Yuto2511/RoboTrace_kicad_2023/production/RoboTrace_2023_main/MainBoard.png

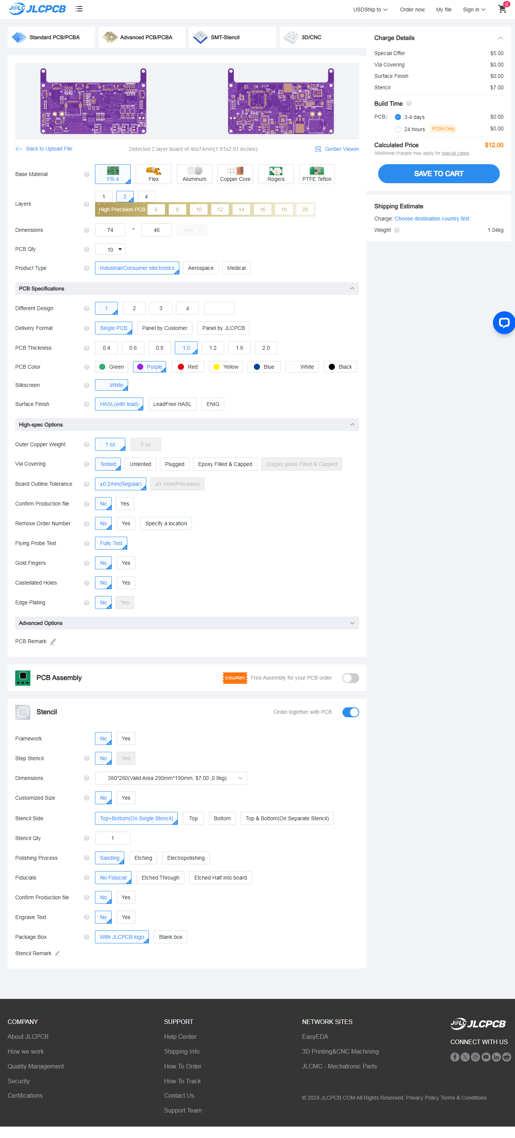
production/RoboTrace_2023_main/MainBoard.png
