Yuto2511/RoboTrace_kicad_2023/production/RoboTrace_2023_sensor/SensorsBoard.png

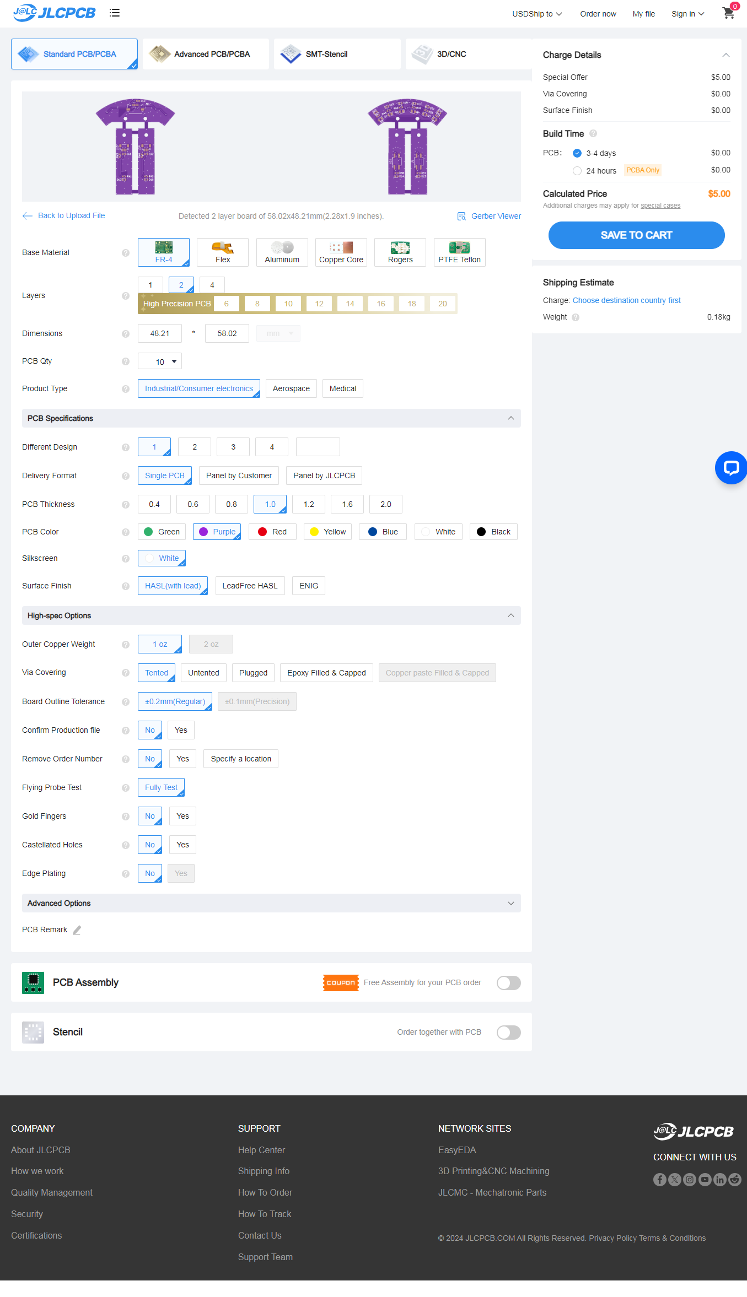
production/RoboTrace_2023_sensor/SensorsBoard.png
