Yuto2511/RoboTrace_kicad_2023/DXF/main.dxf

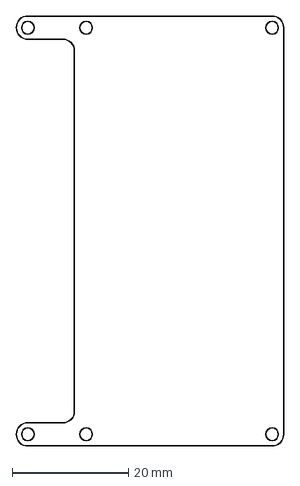
[picture p3: CAD file, 2024-01-15]
DXF/main.dxf
46.0 x 74.0 mm
