Yuto2511/RoboTrace_kicad_2023/DXF/side_sens.dxf

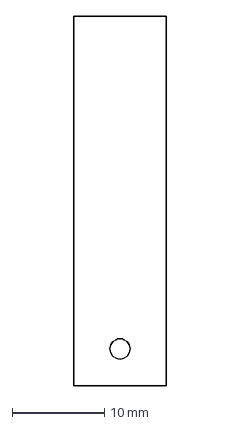
[picture p4: CAD file, 2024-01-15]
DXF/side_sens.dxf
10.0 x 40.0 mm
