Yuto2511/RoboTrace_kicad_2023/DXF/line_sens.dxf

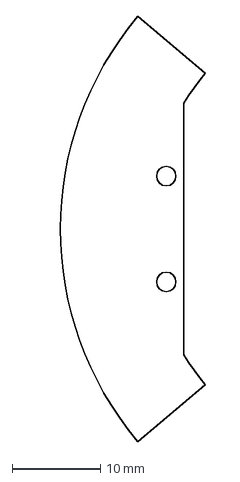
[picture p5: CAD file, 2024-01-15]
DXF/line_sens.dxf
19.4 x 48.2 mm
