Yuto2511/RoboTrace_kicad_2023/RoboTrace_2023_v2.kicad_pcb

## KiCad design RoboTrace_2023_v2.kicad_pcb (2024-01-17)

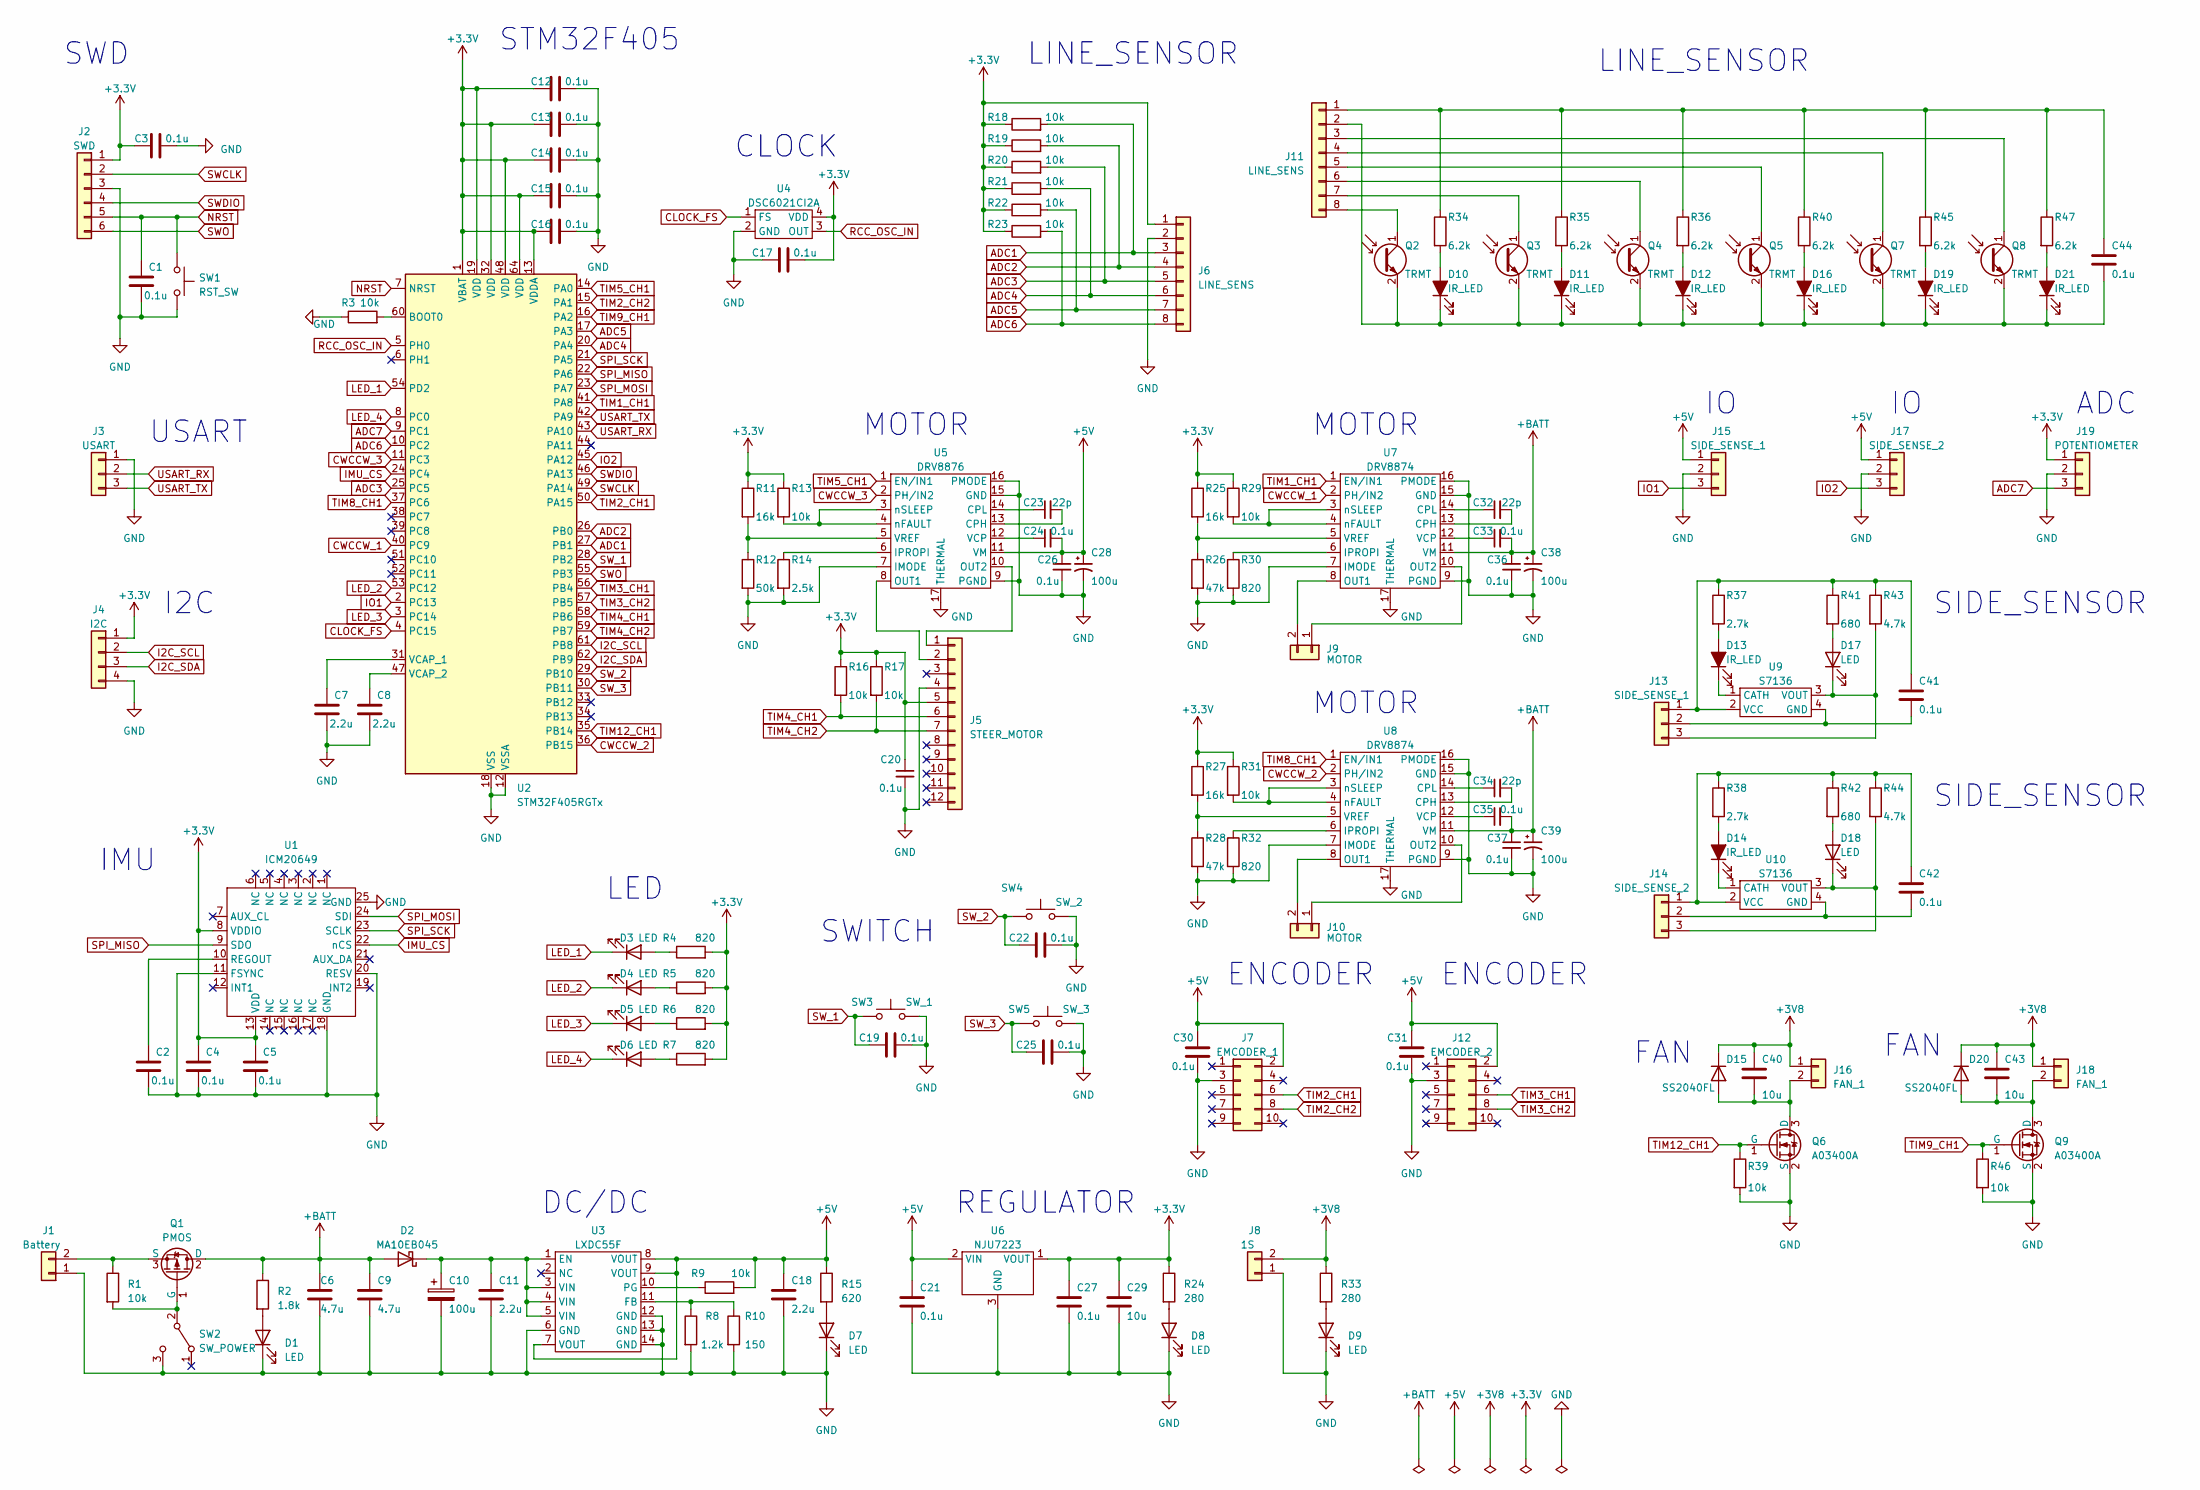
[picture p6: schematic RoboTrace_2023_v2.kicad_sch]

Parts:
C1, C2, C3, C4, C5, C12, C13, C14, C15, C16, C17, C19, C20, C21, C22, C24, C25, C26, C27, C30, C31, C33, C35, C36, C37, C41, C42, C44: 0.1u; C_0603_1608Metric
C6, C9: 4.7u; C_1206_3216Metric
C7, C8, C11, C18: 2.2u; C_0603_1608Metric
C10, C28, C38, C39: 100u; CP_EIA-7343-15_Kemet-W
C23, C32, C34: 22p; C_0603_1608Metric
C29, C40, C43: 10u; C_0805_2012Metric
D1, D3, D4, D5, D6, D7, D8, D9, D17, D18: LED; LED_0603_1608Metric
D2: MA10EB045; SO-221BC
D10, D11, D12, D13, D14, D16, D19, D21: IR_LED; LED_0603_1608Metric
D15, D20: SS2040FL; D_SOD-123F
J1: Battery; AMASS_XT30PW-M_1x02_P2.50mm_Horizontal
J2: SWD; JST_SH_BM06B-SRSS-TB_1x06-1MP_P1.00mm_Vertical
J3: USART; JST_SH_BM03B-SRSS-TB_1x03-1MP_P1.00mm_Vertical
J4: I2C; JST_SH_BM04B-SRSS-TB_1x04-1MP_P1.00mm_Vertical
J5: STEER_MOTOR; Molex_200528-0120_1x12-0.5MP_P0.50mm_Horizontal
J6, J11: LINE_SENS; Molex_200528-0080_1x08-0.5MP_P0.50mm_Horizontal
J7: EMCODER_1; PinHeader_2x05_P1.27mm_Vertical
J8: 1S; IL-G_2PIN
J9, J10: MOTOR; JST_PH_B2B-PH-K_1x02_P2.00mm_Vertical
J12: EMCODER_2; PinHeader_2x05_P1.27mm_Vertical
J13, J15: SIDE_SENSE_1; JST_SH_BM03B-SRSS-TB_1x03-1MP_P1.00mm_Vertical
J14, J17: SIDE_SENSE_2; JST_SH_BM03B-SRSS-TB_1x03-1MP_P1.00mm_Vertical
J16, J18: FAN_1; JST_PH_B2B-PH-K_1x02_P2.00mm_Vertical
J19: POTENTIOMETER; JST_SH_BM03B-SRSS-TB_1x03-1MP_P1.00mm_Vertical
Q1: PMOS; TO-252-3_TabPin2
Q2, Q3, Q4, Q5, Q7, Q8: TRMT; LED_0805_2012Metric
Q6, Q9: A03400A; SOT-23
R1, R3, R9, R13, R16, R17, R18, R19, R20, R21, R22, R23, R29, R31, R39, R46: 10k; R_0603_1608Metric
R2: 1.8k; R_0603_1608Metric
R4, R5, R6, R7, R30, R32: 820; R_0603_1608Metric
R8: 1.2k; R_0603_1608Metric
R10: 150; R_0603_1608Metric
R11, R25, R27: 16k; R_0603_1608Metric
R12: 50k; R_0603_1608Metric
R14: 2.5k; R_0603_1608Metric
R15: 620; R_0603_1608Metric
R24, R33: 280; R_0603_1608Metric
R26, R28: 47k; R_0603_1608Metric
R34, R35, R36, R40, R45, R47: 6.2k; R_0603_1608Metric
R37, R38: 2.7k; R_0603_1608Metric
R41, R42: 680; R_0603_1608Metric
R43, R44: 4.7k; R_0603_1608Metric
SW1: RST_SW; SW_SPST_B3U-1000P
SW2: SW_POWER; SSAJ12
SW3: SW_1; SW_SPST_B3U-1000P
SW4: SW_2; SW_SPST_B3U-1000P
SW5: SW_3; SW_SPST_B3U-1000P
U1: ICM20649; QFN-24-1EP_3x3mm_P0.4mm_EP1.75x1.6mm_ThermalVias
U2: STM32F405RGTx; LQFP-64_10x10mm_P0.5mm
U3: LXDC55F; LXDC55FAAA203
U4: DSC6021CI2A
U5: DRV8876; HTSSOP-16-1EP_4.4x5mm_P0.65mm_EP3.4x5mm_Mask2.46x2.31mm_The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
U6: NJU7223; TO-252-2
U7, U8: DRV8874; HTSSOP-16-1EP_4.4x5mm_P0.65mm_EP3.4x5mm_Mask2.46x2.31mm_The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
U9, U10: S7136

Connections:
+3.3V: C3.1, C4.1, C5.1, C12.1, C13.1, C14.1, C15.1, C16.1, C17.2, C20.1, C27.1, C29.1, J2.1, J4.1, J5.5, J6.1, J19.1, R4.2, R5.2, R6.2, R7.2, R11.1, R13.1, R16.1, R17.1, R18.1, R19.1, R20.1, R21.1, R22.1, R23.1, R24.1, R25.1, R27.1, R29.1, R31.1, U1.8 (VDDIO), U1.13 (VDD), U2.1 (VBAT), U2.13 (VDDA), U2.19 (VDD), U2.32 (VDD), U2.48 (VDD), U2.64 (VDD), U4.4 (VDD), U6.1 (VOUT)
+3V8: C40.1, C43.1, D15.1 (K), D20.1 (K), J8.2, J16.1, J18.1, R33.1
+5V: C18.1, C21.1, C24.2, C26.1, C28.1, C30.1, C31.1, J7.2, J12.2, J15.1, J17.1, R9.2, R15.1, U3.7 (VOUT), U3.8 (VOUT), U3.9 (VOUT), U5.11 (VM), U6.2 (VIN)
+BATT: C6.1, C9.1, C33.2, C35.2, C36.1, C37.1, C38.1, C39.1, D2.2 (A), Q1.2 (D), R2.1, U7.11 (VM), U8.11 (VM)
ADC1: J6.3, R18.2, U2.27 (PB1)
ADC2: J6.4, R19.2, U2.26 (PB0)
ADC3: J6.5, R20.2, U2.25 (PC5)
ADC4: J6.6, R21.2, U2.20 (PA4)
ADC5: J6.7, R22.2, U2.17 (PA3)
ADC6: J6.8, R23.2, U2.10 (PC2)
ADC7: J19.3, U2.9 (PC1)
CLOCK_FS: U2.4 (PC15), U4.1 (FS)
CWCCW_1: U2.40 (PC9), U7.2 (PH/IN2)
CWCCW_2: U2.36 (PB15), U8.2 (PH/IN2)
CWCCW_3: U2.11 (PC3), U5.2 (PH/IN2)
GND: C1.2, C2.2, C3.2, C4.2, C5.2, C6.2, C7.2, C8.2, C9.2, C10.2, C11.2, C12.2, C13.2, C14.2, C15.2, C16.2, C17.1, C18.2, C19.2, C20.2, C21.2, C22.2, C25.2, C26.2, C27.2, C28.2, C29.2, C30.2, C31.2, C36.2, C37.2, C38.2, C39.2, D1.1 (K), D7.1 (K), D8.1 (K), D9.1 (K), J1.1, J2.3, J3.1, J4.4, J5.4, J6.2, J7.3, J8.1, J12.3, J15.2, J17.2, J19.2, Q6.2 (S), Q9.2 (S), R3.1, R8.2, R10.2, R12.2, R14.2, R26.2, R28.2, R30.2, R32.2, R39.2, R46.2, SW1.2, SW2.3 (C), SW3.2, SW4.2, SW5.2, U1.11 (FSYNC), U1.18 (GND), U1.20 (RESV), U1.25 (GND), U2.12 (VSSA), U2.18 (VSS), U2.63 (VSS), U3.6 (GND), U3.12 (GND), U3.13 (GND), U3.14 (GND), U4.2 (GND), U5.7 (IMODE), U5.9 (PGND), U5.15 (GND), U5.16 (PMODE), U5.17 (THERMAL), U6.3 (GND), U7.7 (IMODE), U7.9 (PGND), U7.15 (GND), U7.16 (PMODE), U7.17 (THERMAL), U8.7 (IMODE), U8.9 (PGND), U8.15 (GND), U8.16 (PMODE), U8.17 (THERMAL)
I2C_SCL: J4.2, U2.61 (PB8)
I2C_SDA: J4.3, U2.62 (PB9)
IMU_CS: U1.22 (nCS), U2.24 (PC4)
IO1: J15.3, U2.2 (PC13)
IO2: J17.3, U2.45 (PA12)
LED_1: D3.1 (K), U2.54 (PD2)
LED_2: D4.1 (K), U2.53 (PC12)
LED_3: D5.1 (K), U2.3 (PC14)
LED_4: D6.1 (K), U2.8 (PC0)
NRST: C1.1, J2.5, SW1.1, U2.7 (NRST)
unnamed: D1.2 (A), R2.2
unnamed: C10.1, C11.1, D2.1 (K), U3.1 (EN), U3.3 (VIN), U3.4 (VIN), U3.5 (VIN)
unnamed: D3.2 (A), R4.1
unnamed: D4.2 (A), R5.1
unnamed: D5.2 (A), R6.1
unnamed: D6.2 (A), R7.1
unnamed: D7.2 (A), R15.2
unnamed: D8.2 (A), R24.2
unnamed: D9.2 (A), R33.2
unnamed: D10.2 (A), R34.2
unnamed: C44.2, D10.1 (K), D11.1 (K), D12.1 (K), D16.1 (K), D19.1 (K), D21.1 (K), J11.2, Q2.2 (E), Q3.2 (E), Q4.2 (E), Q5.2 (E), Q7.2 (E), Q8.2 (E)
unnamed: D11.2 (A), R35.2
unnamed: D12.2 (A), R36.2
unnamed: D13.2 (A), R37.2
unnamed: D13.1 (K), U9.1 (CATH)
unnamed: D14.2 (A), R38.2
unnamed: D14.1 (K), U10.1 (CATH)
unnamed: C40.2, D15.2 (A), J16.2, Q6.3 (D)
unnamed: D16.2 (A), R40.2
unnamed: D17.2 (A), R41.2
unnamed: D17.1 (K), J13.3, R43.2, U9.3 (VOUT)
unnamed: D18.2 (A), R42.2
unnamed: D18.1 (K), J14.3, R44.2, U10.3 (VOUT)
unnamed: D19.2 (A), R45.2
unnamed: C43.2, D20.2 (A), J18.2, Q9.3 (D)
unnamed: D21.2 (A), R47.2
unnamed: J1.2, Q1.3 (S), R1.1
unnamed: J5.1, U5.10 (OUT2)
unnamed: J5.2, U5.8 (OUT1)
unnamed: J9.1, U7.10 (OUT2)
unnamed: J9.2, U7.8 (OUT1)
unnamed: J10.1, U8.10 (OUT2)
unnamed: J10.2, U8.8 (OUT1)
unnamed: C44.1, J11.1, R34.1, R35.1, R36.1, R40.1, R45.1, R47.1
unnamed: J11.3, Q8.1 (C)
unnamed: J11.4, Q7.1 (C)
unnamed: J11.5, Q5.1 (C)
unnamed: J11.6, Q4.1 (C)
unnamed: J11.7, Q3.1 (C)
unnamed: J11.8, Q2.1 (C)
unnamed: C41.1, J13.1, R37.1, R41.1, R43.1, U9.2 (VCC)
unnamed: C41.2, J13.2, U9.4 (GND)
unnamed: C42.1, J14.1, R38.1, R42.1, R44.1, U10.2 (VCC)
unnamed: C42.2, J14.2, U10.4 (GND)
unnamed: Q1.1 (G), R1.2, SW2.2 (B)
unnamed: C2.1, U1.10 (REGOUT)
unnamed: R3.2, U2.60 (BOOT0)
unnamed: C7.1, U2.31 (VCAP_1)
unnamed: C8.1, U2.47 (VCAP_2)
unnamed: R8.1, R10.1, U3.11 (FB)
unnamed: R9.1, U3.10 (PG)
unnamed: C23.2, U5.13 (CPH)
unnamed: C23.1, U5.14 (CPL)
unnamed: R14.1, U5.6 (IPROPI)
unnamed: C24.1, U5.12 (VCP)
unnamed: R11.2, R12.1, U5.5 (VREF)
unnamed: R13.2, U5.3 (nSLEEP), U5.4 (nFAULT)
unnamed: C32.2, U7.13 (CPH)
unnamed: C32.1, U7.14 (CPL)
unnamed: R30.1, U7.6 (IPROPI)
unnamed: C33.1, U7.12 (VCP)
unnamed: R25.2, R26.1, U7.5 (VREF)
unnamed: R29.2, U7.3 (nSLEEP), U7.4 (nFAULT)
unnamed: C34.2, U8.13 (CPH)
unnamed: C34.1, U8.14 (CPL)
unnamed: R32.1, U8.6 (IPROPI)
unnamed: C35.1, U8.12 (VCP)
unnamed: R27.2, R28.1, U8.5 (VREF)
unnamed: R31.2, U8.3 (nSLEEP), U8.4 (nFAULT)
RCC_OSC_IN: U2.5 (PH0), U4.3 (OUT)
SPI_MISO: U1.9 (SDO), U2.22 (PA6)
SPI_MOSI: U1.24 (SDI), U2.23 (PA7)
SPI_SCK: U1.23 (SCLK), U2.21 (PA5)
SWCLK: J2.2, U2.49 (PA14)
SWDIO: J2.4, U2.46 (PA13)
SWO: J2.6, U2.55 (PB3)
SW_1: C19.1, SW3.1, U2.28 (PB2)
SW_2: C22.1, SW4.1, U2.29 (PB10)
SW_3: C25.1, SW5.1, U2.30 (PB11)
TIM1_CH1: U2.41 (PA8), U7.1 (EN/IN1)
TIM2_CH1: J7.6, U2.50 (PA15)
TIM2_CH2: J7.8, U2.15 (PA1)
TIM3_CH1: J12.6, U2.56 (PB4)
TIM3_CH2: J12.8, U2.57 (PB5)
TIM4_CH1: J5.6, R16.2, U2.58 (PB6)
TIM4_CH2: J5.7, R17.2, U2.59 (PB7)
TIM5_CH1: U2.14 (PA0), U5.1 (EN/IN1)
TIM8_CH1: U2.37 (PC6), U8.1 (EN/IN1)
TIM9_CH1: Q9.1 (G), R46.1, U2.16 (PA2)
TIM12_CH1: Q6.1 (G), R39.1, U2.35 (PB14)
USART_RX: J3.2, U2.43 (PA10)
USART_TX: J3.3, U2.42 (PA9)

Notes on the sheet:
MOTOR
ENCODER
CLOCK
SWITCH
SIDE_SENSOR
REGULATOR
SWD
FAN
DC/DC
STM32F405
LINE_SENSOR
LED
ADC
USART
I2C
IMU

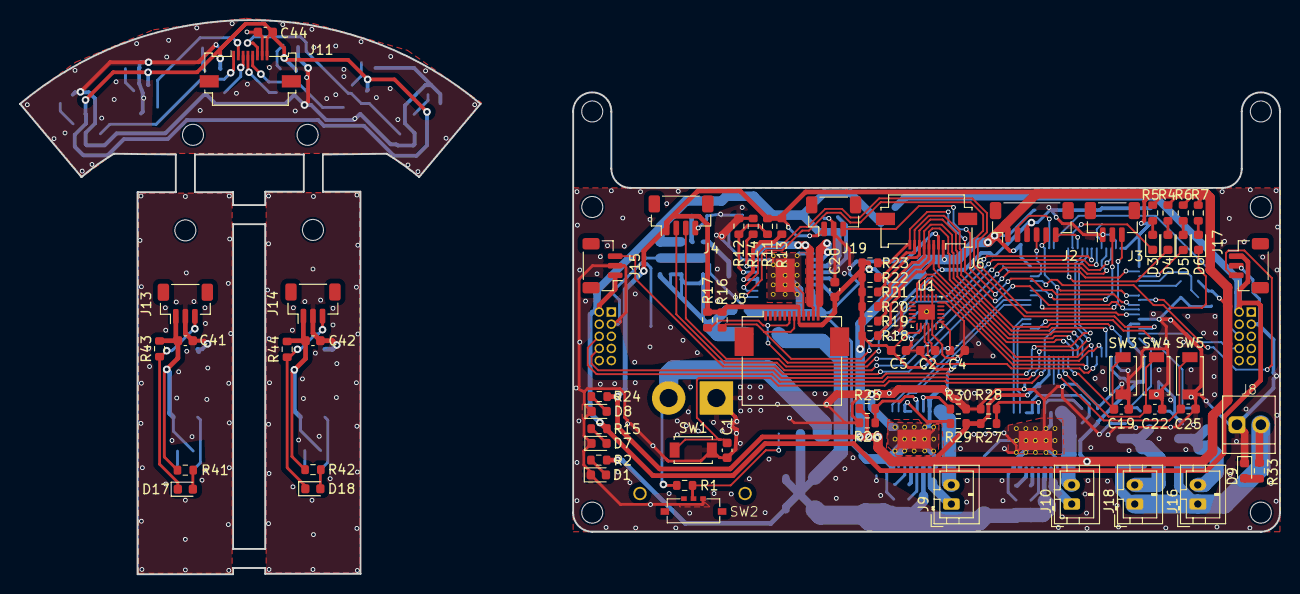
[picture p7: board RoboTrace_2023_v2.kicad_pcb from above]

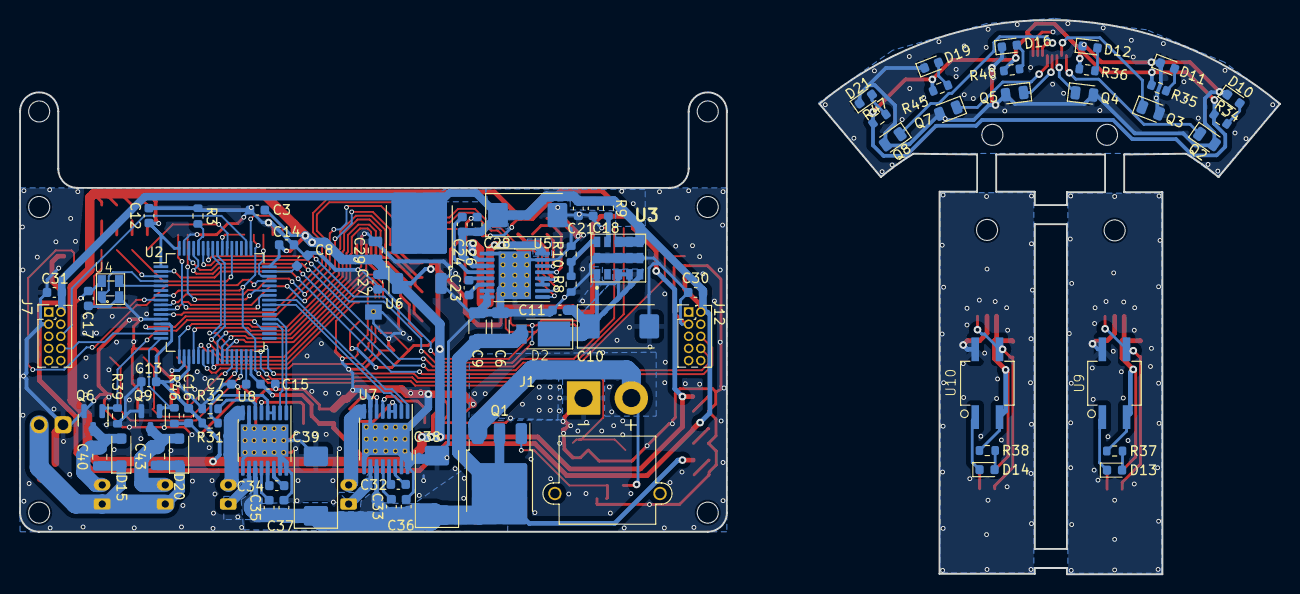
[picture p8: board RoboTrace_2023_v2.kicad_pcb from below]

Board: 2 copper layers, 131.9 x 58.0 mm, 155 parts (81 on the bottom side), 118 nets.
