Yuto2511/RoboTrace_kicad_2023/(commit log)

2024-01-17 third commit
    [RoboTrace_2023_v2.kicad_pcb]
2024-01-17 add production
    [RoboTrace_2023_v2.kicad_pcb, bom.csv, designators.csv, positions.csv]
